mustafakinacii/zekaland-microduck-tr/modeller/README.md

# Modeller

| Klasör | İçerik |
|---|---|
| [`feetech/`](feetech/) | **Bambu Studio projesi** (`zekaland-robot-ordek-feetech.3mf`, 6 tabla, ayarlar hazır) ve tek tek STL'ler (`stl/`). Ayak tabanlarında ZEKALAND yazısı var. |
| [`zekaland/`](zekaland/) | Zekaland aksesuarları: sırt rozeti (52×14 mm) ve sergileme kaidesi (150×100 mm) |
| [`montaj-gorselleri/`](montaj-gorselleri/) | 15 alt grubun montaj ve patlatılmış görünüm resimleri |
| [`montaj-kilavuzu.pdf`](montaj-kilavuzu.pdf) | Montaj kılavuzu (Türkçe PDF, 23 sayfa, yazdırmaya hazır). Web sürümü: [belgeler/18-montaj-kilavuzu.md](../belgeler/18-montaj-kilavuzu.md) |

Baskı ayarları, süreler ve malzeme önerileri: [belgeler/12-baski-ve-cad.md](../belgeler/12-baski-ve-cad.md).

ZEKALAND parçaları
