mustafakinacii/zekaland-microduck-tr/belgeler/17-baslangic-rehberi.md

# İmaj Yazma ve İlk Kullanım

İmajı indirmekten, kartı yazmaya (imaj yazma) ve ağ yapılandırmasına; servo ve IMU kalibrasyonuna, gamepad eşleştirmeye ve yürümeye başlamaya kadar.

| Okuma biçimi | Giriş | Uygulandığı durum |
|---|---|---|
| **Güncel web sürümü açıklaması** | **[İmaj yazma ve ilk kullanım belgesini aç](10-imaj-yazma-ve-ilk-kullanim.md)** | Proje ile birlikte güncellenir, 20261023c'nin IMU uyumluluk kapsamını içerir |
| **PDF görselli rehber** | **[Başlangıç rehberi V2'yi önizle / indir](https://github.com/fanhao375/microduck-replica/blob/789ef5e45b6102d7e71fecefbf58606520147cfa/docs/上手指南/Microduck上手指南-V2-20261022.pdf)** | 2026-10-22'de derlendi, 21 sayfa, yazdırılabilir; görseller 20261021b imajına dayanır, sürüm farklarında güncel web sürümü açıklaması esas alınır |

PDF; indirme ve kart yazma, hotspot'a bağlanma ve ağ yapılandırması, servo ve IMU kalibrasyonu, gamepad, acil durdurma ve yürümeyi kapsar. Özgün doküman içeriği korunmuştur.

[İmajı indir](https://github.com/fanhao375/microduck-replica/releases/latest) · [CAD ve baskı dosyaları](https://github.com/fanhao375/microduck-replica-cad) · [Feetech sürümü satın alma listesi](02-malzeme-listesi-bom.md) · [Donanım projeleri](13-devre-kartlari.md)

---
*Zekaland Robot Ördek belgeleri · Lisans ve katkıda bulunanlar: [ATIF.md](../ATIF.md)*
