mustafakinacii/zekaland-microduck-tr/belgeler/02-malzeme-listesi-bom.md

# Feetech Sürümü Montaj Satın Alma Listesi

**Hazırlayan: 机械行者Robo · 2026-10-23 sürümü**

**[Tam Excel dosyasını indir](https://github.com/fanhao375/microduck-replica/blob/789ef5e45b6102d7e71fecefbf58606520147cfa/BOM/装配BOM-机械行者Robo-2026-10-23-带采购链接.xlsx)** · [Baskı parçaları ve CAD](https://github.com/fanhao375/microduck-replica-cad) · [Ana depo](https://github.com/fanhao375/microduck-replica)

Bu sayfa, aynı sürümün Excel dosyasından derlenmiştir; **33 baskı parçası ve 23 satın alınan parça** içerir. Adetler, malzemeler, notlar, fiyatlar ve satın alma bağlantıları orijinal tablodaki gibi korunmuştur.

**Geçerli sürüm: Feetech HD-1910 yapısı.** Liste, Feetech servoları ve URT2 programlama/test kartını içerir; XL330 sürümü için servolar ve ilgili elektronik ayrıca kontrol edilmelidir. Excel'in orijinal dosyası değiştirilmemiştir.

[Baskı parçalarına git](#1-baskı-parçaları-33-kalem) · [Satın alınan parçalara git](#2-satın-alınan-parçalar-23-kalem) · [Orijinal tablo notları ve doğrulanacak noktalar](#3-orijinal-tablo-notları-ve-doğrulanacak-noktalar)

## 1. Baskı parçaları (33 kalem)

Baskı modellerini [CAD deposundan](https://github.com/fanhao375/microduck-replica-cad) kendi servo sürümünüze uygun olarak seçin. Malzemeyi ayrıca o sürümün baskı açıklamasıyla karşılaştırın; aşağıdaki tabloda Excel'deki orijinal metin gösterilmektedir. (Dosya adlarındaki Çince bölümler orijinaldir ve değiştirilmemiştir.)

**Tüm baskı parçaları seti için fiyat kaydı: 139 yuan** (¥ = Çin yuanı), orijinal tablodaki birleştirilmiş I3:I35 alanına karşılık gelir; [satın alma bağlantısı (Taobao)](<https://item.taobao.com/item.htm?id=1083122166800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>).

| No | Ad | Orijinal dosya adı | Malzeme (orijinal tablo) | Adet | Not (orijinal tablo) |
|---|---|---|---|---:|---|
| 1 | Kafa üst kabuk | top_head_shell_头部上壳.stp | PLA | 1 |  |
| 2 | Kafa alt kabuk | bottom_head_shell_头部下壳.stp | PLA | 1 |  |
| 3 | Yüz parçası | face_part_面部零件.stp | PLA | 1 |  |
| 4 | Çene | jaw_下巴.stp | PLA | 1 |  |
| 5 | Yumuşak çene | jaw_soft_软下巴.stp | PLA | 1 | TPU esnek filament önerilir |
| 6 | Yumuşak gaga üstü | soft_mouth_top_软嘴顶部.stp | PLA | 1 | TPU esnek filament önerilir |
| 7 | Gözler | noenoeil_眼睛.stp | PLA | 1 |  |
| 8 | Boyun | neck_颈部.stp | PLA | 2 | Alüminyum alaşım önerilir |
| 9 | Boyun eğim (pitch) | neck_pitch_颈部俯仰.stp | PLA | 1 |  |
| 10 | Gövde tabanı | trunk_base_躯干底座.stp | PLA | 1 | Alüminyum alaşım önerilir |
| 11 | Sol kabuk | left_shell_左壳.stp | PLA | 1 |  |
| 12 | Sağ kabuk | right_shell_右壳.stp | PLA | 1 |  |
| 13 | Kalça sol | hip_l_髋部左.stp | PLA | 2 |  |
| 14 | Yaw'dan roll'a dönüşüm | yaw2roll_偏航转横滚.stp | PLA | 1 |  |
| 15 | Yaw-roll hareketi | yaw_roll_motion_偏航横滚运动.stp | PLA | 1 |  |
| 16 | Bacak | leg_腿部.stp | PLA | 2 |  |
| 17 | Sol üst bacak | left_upper_leg_左上腿.stp | PLA | 1 |  |
| 18 | Sağ üst bacak | right_upper_leg_右上腿.stp | PLA | 1 |  |
| 19 | Üst bacak takviye plakası | upper_leg_rigidity_plate_上腿加固板.stp | PLA | 2 | Alüminyum alaşım önerilir |
| 20 | Sol ayak | foot_left_左脚.stp | PLA | 1 |  |
| 21 | Sağ ayak | foot_right_右脚.stp | PLA | 1 |  |
| 22 | Sol taban | sole_left_左脚底.stp | PLA | 1 |  |
| 23 | Sağ taban | sole_right_右脚底.stp | PLA | 1 |  |
| 24 | Bilek sol | ankle_left_脚踝左.stp | PLA | 1 |  |
| 25 | Bilek sağ | ankle_right_脚踝右.stp | PLA | 1 |  |
| 26 | Bilek sol (V1 alternatif) | ankle_l_v1_脚踝左V1.stp | PLA | 1 |  |
| 27 | Bilek sağ (V1 alternatif) | ankle_r_v1_脚踝右V1.stp | PLA | 1 |  |
| 28 | Birleşik lastik | 合体轮胎.stp | PLA | 4 |  |
| 29 | Tekerlek kanadı | roller_blade_滚轮叶片.stp | PLA | 2 |  |
| 30 | Motor desteği | motor_support_电机支架.stp | PLA | 1 |  |
| 31 | Güç (batarya) desteği | power_support_电源支架.stp | PLA | 1 |  |
| 32 | Muz biçimli PCB kilidi | banana_pcb_locker_香蕉形PCB锁扣.stp | PLA | 1 |  |
| 33 | Rulmanlı tekerlek | bearing_roll_轴承滚轮.stp | PLA | 2 | Alüminyum alaşım önerilir |

## 2. Satın alınan parçalar (23 kalem)

Fiyat birimi yuandır (¥); değerler orijinal tabloda kayıtlı sayılar olarak gösterilmiştir. Satın alma bağlantılarına doğrudan tıklanabilir; Excel'de adres girilmemiş kalemler "Orijinal tabloda girilmemiş" olarak işaretlenmiştir.

| No | Ad | Kategori | Adet | Birim fiyat | Toplam fiyat (orijinal tablo) | Not (orijinal tablo) | Satın alma girişi |
|---|---|---|---:|---:|---:|---|---|
| 1 | Radxa Zero 3W ana kart | Elektronik parça | 1 | 309 | 309 |  | [Satın alma bağlantısı (Taobao)](<https://item.taobao.com/item.htm?id=763812025816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>) |
| 2 | 64GB TF (microSD) kart | Elektronik parça | 1 | 60 | 60 |  | Orijinal tabloda girilmemiş |
| 3 | Raspberry Pi robot HAT devre kartı | Elektronik parça | 1 | 120 | 120 | Ortak (grup) sipariş mümkün, GitHub | [Proje girişi (GitHub)](<https://github.com/fanhao375/microduck-replica>) |
| 4 | imu_to_dxl devre kartı | Elektronik parça | 1 | 80 | 80 | Ortak (grup) sipariş mümkün, GitHub | [Proje girişi (GitHub)](<https://github.com/fanhao375/microduck-replica>) |
| 5 | Feetech HD1901M servo | Elektronik parça | 15 | 95 | 1425 | Ortak (grup) sipariş mümkün, GitHub | [Proje girişi (GitHub)](<https://github.com/fanhao375/microduck-replica>) |
| 6 | Feetech servo URT2 programlama/test kartı | Elektronik parça | 1 | 45 | 45 |  | [Satın alma bağlantısı (Taobao)](<https://item.taobao.com/item.htm?id=575365901461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>) |
| 7 | NP-F550 batarya | Elektronik parça | 1 | 17 | 47 |  | [Satın alma bağlantısı (Taobao)](<https://item.taobao.com/item.htm?id=769425140324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>) |
| 8 | AMP2.0 çift uçlu dönüşüm kablosu, microduck servo kablosu | Elektronik parça | 1 | 2 | 2 | Hata ayıklama için | [Satın alma bağlantısı (Taobao)](<https://item.taobao.com/item.htm?id=1089647066599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>) |
| 9 | 2.5mm muz (banana) fişi, PCB tipi, altın kaplama bakır | Elektronik parça | 2 | 1.6 | 3.2 |  | [Satın alma bağlantısı (Taobao)](<https://item.taobao.com/item.htm?id=1066300439603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>) |
| 10 | banana PCB | Elektronik parça | 1 | 20 | 20 |  | JLCPCB |
| 11 | IMX219 kamera modülü | Optik parça | 1 | 46.8 | 46.8 |  | [Satın alma bağlantısı (Tmall)](<https://detail.tmall.com/item.htm?id=775872575316>) |
| 12 | VL53L8CX ToF modülü | Elektronik parça | 1 | 49.5 | 49.5 |  | [Satın alma bağlantısı (Taobao)](<https://item.taobao.com/item.htm?id=737603917521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>) |
| 13 | Hoparlör | Elektronik parça | 1 | 3.8 | 3.8 |  | [Satın alma bağlantısı (Taobao)](<https://item.taobao.com/item.htm?id=902489608878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>) |
| 14 | Rulman 10×15×3 | Standart parça | 3 | 2.8 | 8.4 |  | [Satın alma bağlantısı (Taobao)](<https://item.taobao.com/item.htm?id=670727787832>) |
| 15 | Rulman 16×22×4 | Standart parça | 11 | 3.5 | 38.5 |  | [Satın alma bağlantısı (Taobao)](<https://item.taobao.com/item.htm?id=539024647147&skuId=5716548727712>) |
| 16 | Rulman 6×12×3 | Standart parça | 4 | 0.88 | 3.52 | Paten rulmanı | [Satın alma bağlantısı (Taobao)](<https://item.taobao.com/item.htm?id=963037239628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>) |
| 17 | Sac vidası, düz başlı M2×5 | Standart parça | 1 paket | 3.05 | 3.05 |  | [Satın alma bağlantısı (Tmall)](<https://detail.tmall.com/item.htm?id=534923831046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>) |
| 18 | Sac vidası, düz başlı M2×6 | Standart parça | 1 paket | 4.05 | 4.05 |  | [Satın alma bağlantısı (Tmall)](<https://detail.tmall.com/item.htm?id=534923831046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>) |
| 19 | Sac vidası, düz başlı M2×8 | Standart parça | 1 paket | 4.05 | 4.05 |  | [Satın alma bağlantısı (Tmall)](<https://detail.tmall.com/item.htm?id=534923831046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>) |
| 20 | Sac vidası, düz başlı M2.5×6 | Standart parça | 1 paket | 3.93 | 3.93 |  | [Satın alma bağlantısı (Taobao)](<https://item.taobao.com/item.htm?id=534923831046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>) |
| 21 | Sac vidası, düz başlı M2.5×8 | Standart parça | 1 paket | 2.08 | 2.08 |  | [Satın alma bağlantısı (Taobao)](<https://item.taobao.com/item.htm?id=534923831046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>) |
| 22 | Loctite 243 vida sabitleyici | Standart parça | 1 | 9 | 9 |  | [Satın alma bağlantısı (Taobao)](<https://item.taobao.com/item.htm?id=1056442610986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>) |
| 23 | Ayakkabı tabanı kaymaz ped | Standart parça | 1 | 16 | 16 |  | [Satın alma bağlantısı (Tmall)](<https://detail.tmall.com/item.htm?id=888852278057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>) |

## 3. Orijinal tablo notları ve doğrulanacak noktalar

**Orijinal tablo toplamı: 2426.88 yuan.** Excel'in orijinal dosyası değiştirilmemiştir; aşağıdaki iki noktanın kontrol edilmesi gerekir:

- Toplam formülü `SUM(I3:I58)` olup son kalem olan "ayakkabı tabanı kaymaz ped"i (I59, 16 yuan) içermemektedir.
- "NP-F550 batarya" satırında adet 1, birim fiyat 17 yuan, toplam fiyat 47 yuandır; birim fiyat ile toplam fiyat tutarsızdır.

<details>
<summary>Yazarın Excel'e eklediği orijinal açıklamayı göster</summary>

Açıklama:
🦆 Herkes kendi MicroDuck'ına sahip olabilir!

💰 Proje maliyeti açıklaması
15 servo, HAT kartı ve IMU kartı dışındaki donanımın maliyeti yaklaşık 828 yuandır.
15 servo, HAT kartı ve IMU kartı için GitHub projesi üzerinden ortak (grup) siparişe katılabilir veya ihtiyaca göre JLCPCB, Taobao gibi platformlardan kendiniz satın alabilirsiniz.
İlerleyen dönemde, herkesin MicroDuck'ı daha kolay monte edip hata ayıklayabilmesi için montaj eğitimi ve hata ayıklama eğitimi de açık kaynak olarak yayımlanacaktır.
🤖 Neden açık kaynak?

Daha fazla insanın düşük maliyetle somutlaşmış zekâ (embodied AI), robot kontrolü ve pekiştirmeli öğrenme ile tanışıp öğrenebilmesini istiyoruz.

Herkesin kendi ördeği olsun.

Açık kaynak sayesinde, daha fazla insanın uygulamalı çalışıp sıfırdan somutlaşmış zekâyı keşfedebileceği daha açık ve dostane bir öğrenme ortamını birlikte kurmayı hedefliyoruz.

Bu proje size yardımcı olduysa beğeni bırakmak bize verebileceğiniz en büyük destektir ❤️

GitHub hesabımızı takip edip bir Star ⭐ vermeniz de çok makbule geçer!

🔗 GitHub:
https://github.com/fanhao375/microduck-replica

📕 Xiaohongshu: 机械行者
🎵 Douyin: 机械行者Robo
Bilibili: 机械行者Robo

</details>

---
*Zekaland Robot Ördek belgeleri · Lisans ve katkıda bulunanlar: [ATIF.md](../ATIF.md)*
