mustafakinacii/zekaland-microduck-tr/modeller/feetech/stl/upper_leg_rigidity_plate-FT_2.stl

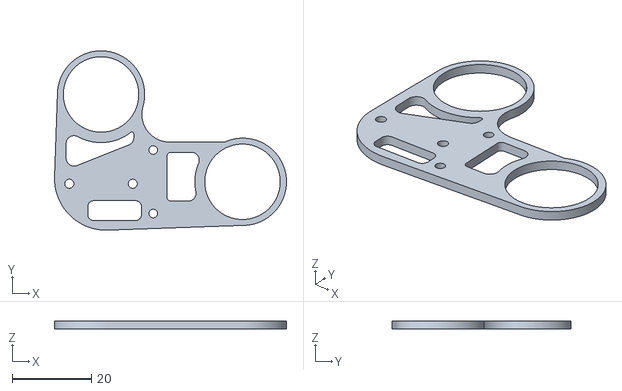
[picture p7: CAD file, 2026-10-30]
modeller/feetech/stl/upper_leg_rigidity_plate-FT_2.stl
58.5 x 45.2 x 2.00
