mustafakinacii/zekaland-microduck-tr/modeller/zekaland/zekaland_rozet.stl

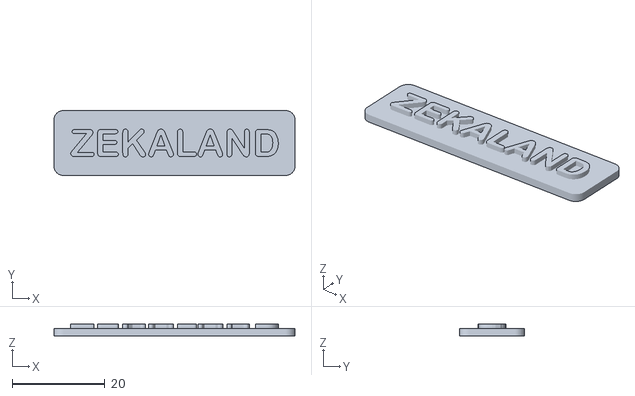
[picture p9: CAD file, 2026-10-30]
modeller/zekaland/zekaland_rozet.stl
52.0 x 14.0 x 2.60
