mustafakinacii/zekaland-microduck-tr/software/training/src/mjlab_microduck/robot/xl330_test_bench/assets/arm.stl

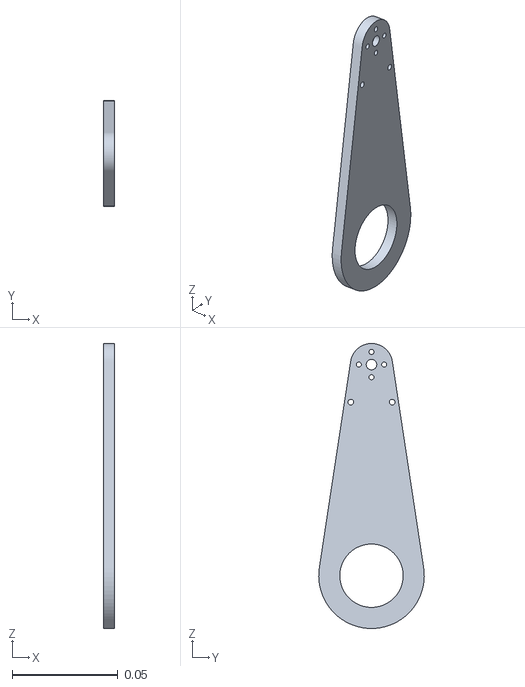
[picture p11: CAD file, 2026-10-30]
software/training/src/mjlab_microduck/robot/xl330_test_bench/assets/arm.stl
0.005 x 0.05 x 0.135
