mustafakinacii/zekaland-microduck-tr/modeller/feetech/stl/bearing_roll-FT.stl

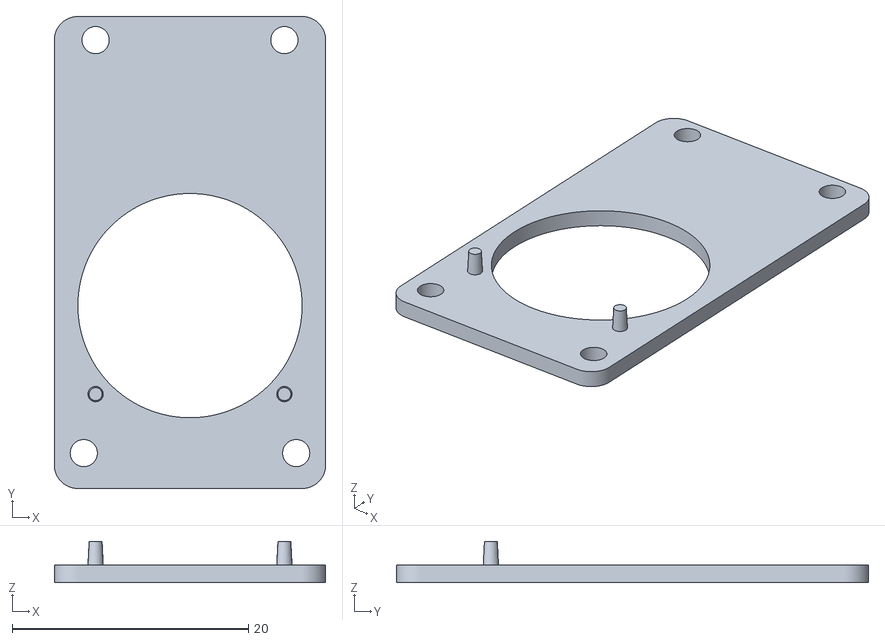
[picture p12: CAD file, 2026-10-30]
modeller/feetech/stl/bearing_roll-FT.stl
23.0 x 40.0 x 3.50
