mustafakinacii/zekaland-microduck-tr/modeller/zekaland/zekaland_kaide.stl

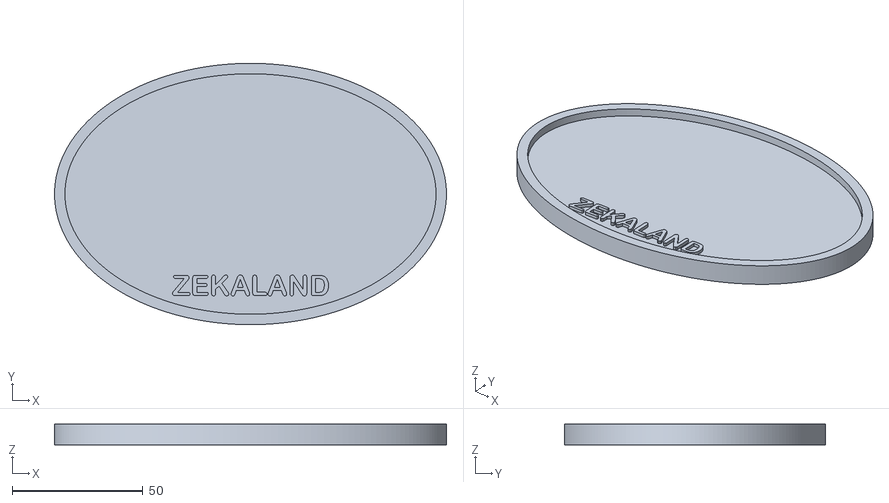
[picture p13: CAD file, 2026-10-30]
modeller/zekaland/zekaland_kaide.stl
150.0 x 100.0 x 8.00
