mustafakinacii/zekaland-microduck-tr/software/training/src/mjlab_microduck/robot/microduck/assets/rim.stl

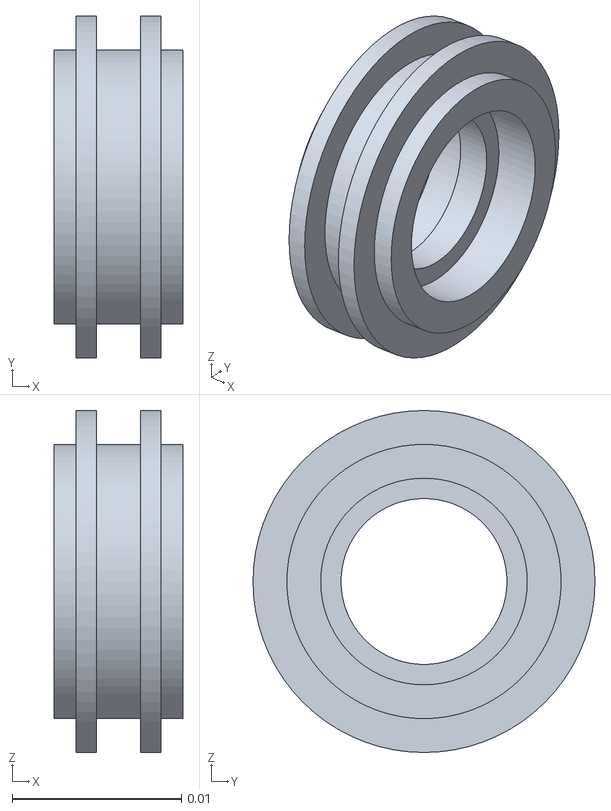
[picture p14: CAD file, 2026-10-30]
software/training/src/mjlab_microduck/robot/microduck/assets/rim.stl
0.0076 x 0.0202 x 0.0202
