mustafakinacii/zekaland-microduck-tr/modeller/feetech/stl/neck_pitch.stl

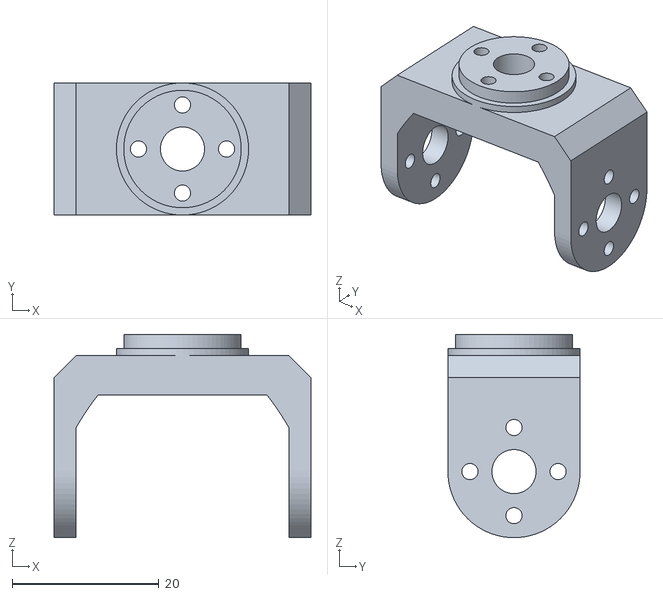
[picture p15: CAD file, 2026-10-30]
modeller/feetech/stl/neck_pitch.stl
35.0 x 18.0 x 27.7
