mustafakinacii/zekaland-microduck-tr/software/training/src/mjlab_microduck/robot/xl330_test_bench/assets/spacer.stl

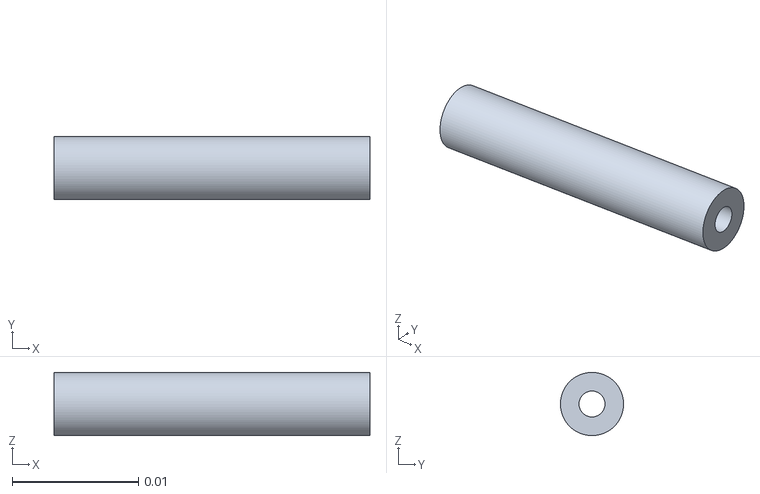
[picture p17: CAD file, 2026-10-30]
software/training/src/mjlab_microduck/robot/xl330_test_bench/assets/spacer.stl
0.025 x 0.005 x 0.005
