mustafakinacii/zekaland-microduck-tr/modeller/feetech/stl/ankle_l_v1_V1.stl

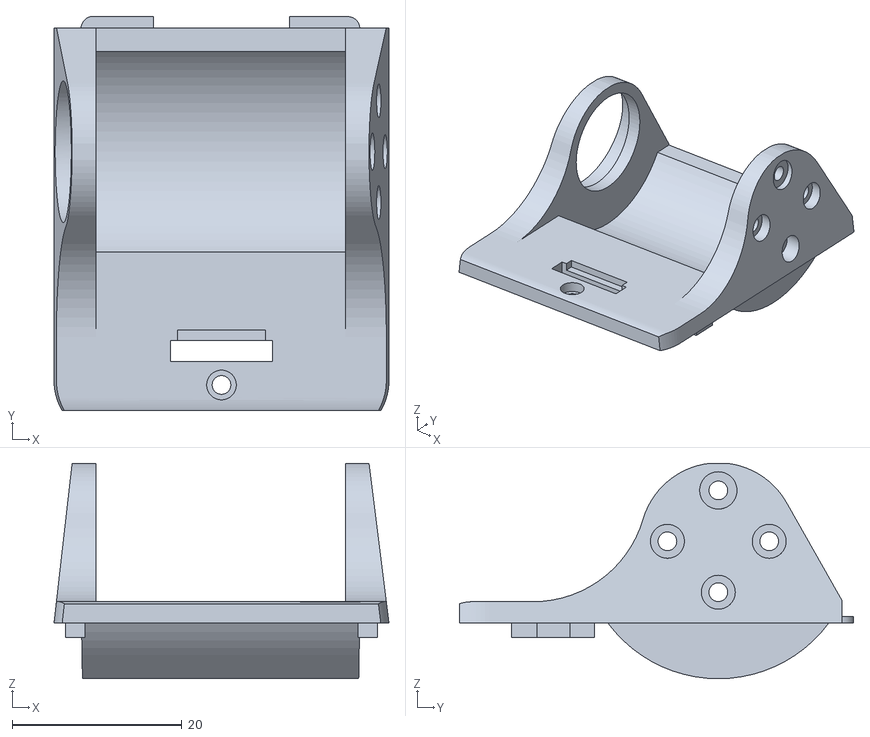
[picture p18: CAD file, 2026-10-30]
modeller/feetech/stl/ankle_l_v1_V1.stl
39.5 x 46.5 x 25.4
