mustafakinacii/zekaland-microduck-tr/software/training/src/mjlab_microduck/robot/microduck/assets/sole_right.stl

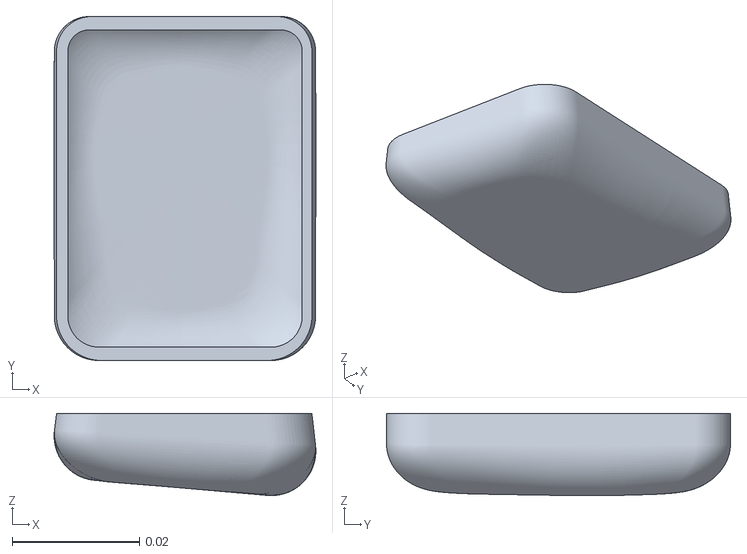
[picture p19: CAD file, 2026-10-30]
software/training/src/mjlab_microduck/robot/microduck/assets/sole_right.stl
0.0411 x 0.054 x 0.0129
