mustafakinacii/zekaland-microduck-tr/software/training/src/mjlab_microduck/robot/xl330_test_bench/assets/weight.stl

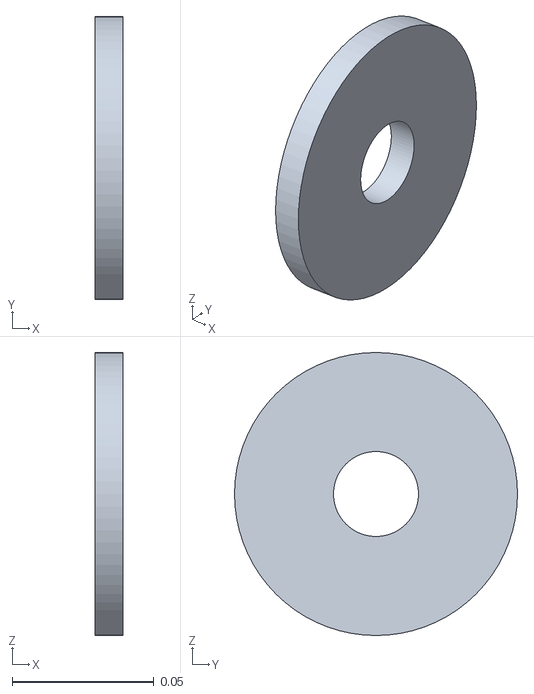
[picture p22: CAD file, 2026-10-30]
software/training/src/mjlab_microduck/robot/xl330_test_bench/assets/weight.stl
0.01 x 0.1 x 0.1
