mustafakinacii/zekaland-microduck-tr/modeller/feetech/stl/yaw_roll_motion-F.stl

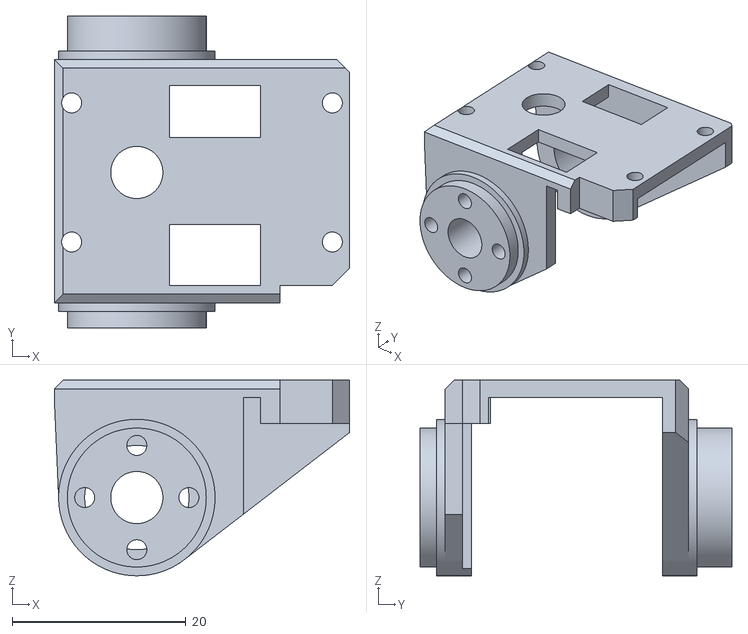
[picture p23: CAD file, 2026-10-30]
modeller/feetech/stl/yaw_roll_motion-F.stl
34.0 x 35.9 x 22.5
