mustafakinacii/zekaland-microduck-tr/modeller/feetech/stl/motor_support.stl

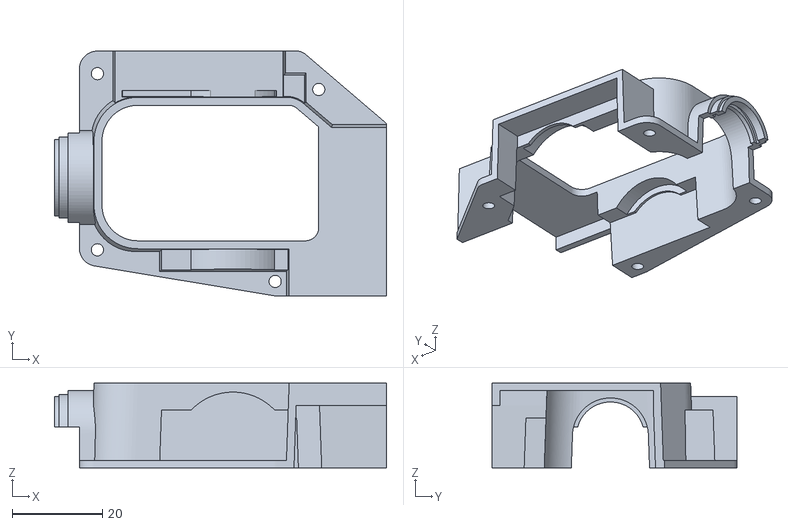
[picture p26: CAD file, 2026-10-30]
modeller/feetech/stl/motor_support.stl
73.5 x 54.2 x 18.8
