mustafakinacii/zekaland-microduck-tr/modeller/feetech/stl/combined_tire_TPU.stl

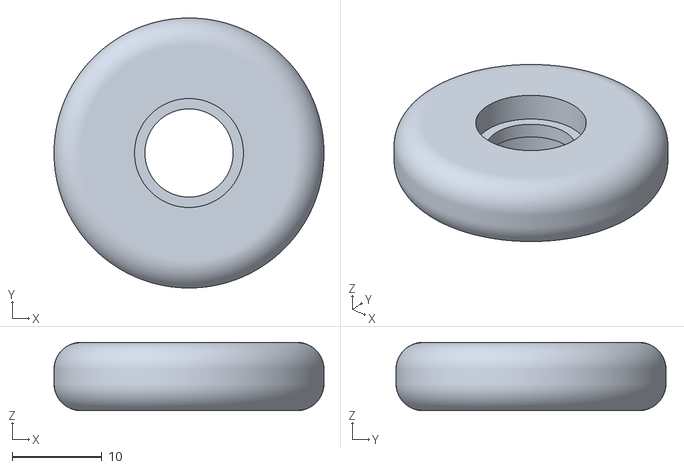
[picture p28: CAD file, 2026-10-30]
modeller/feetech/stl/combined_tire_TPU.stl
30.0 x 30.0 x 7.60
