mustafakinacii/zekaland-microduck-tr/software/training/src/mjlab_microduck/robot/microduck/assets/right_upper_leg.stl

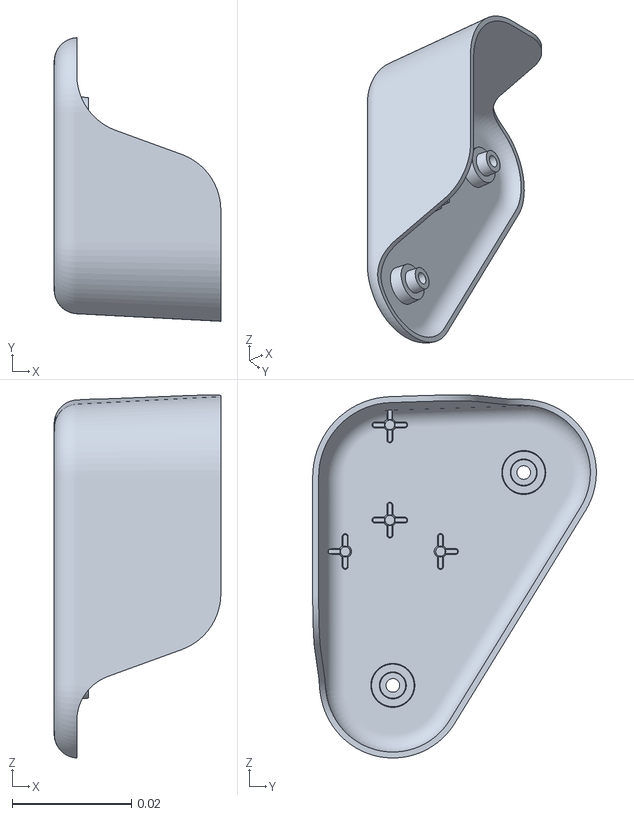
[picture p29: CAD file, 2026-10-30]
software/training/src/mjlab_microduck/robot/microduck/assets/right_upper_leg.stl
0.028 x 0.0477 x 0.061
