mustafakinacii/zekaland-microduck-tr/modeller/feetech/stl/hip_l.stl

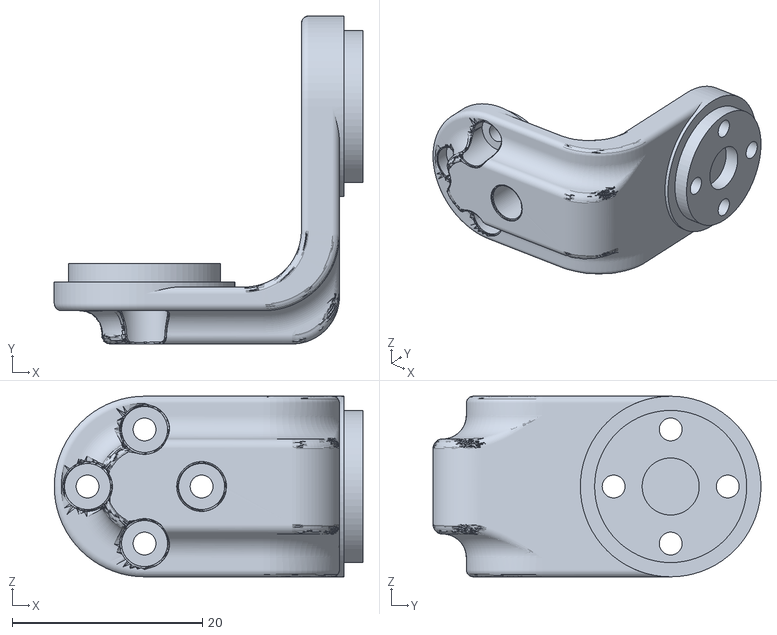
[picture p32: CAD file, 2026-10-30]
modeller/feetech/stl/hip_l.stl
32.5 x 34.5 x 19.0
