mustafakinacii/zekaland-microduck-tr/software/training/src/mjlab_microduck/robot/microduck/assets/ankle_r_v1.stl

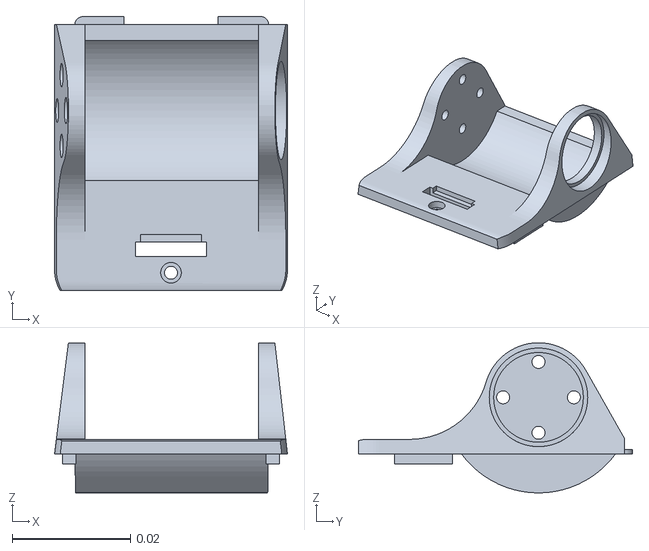
[picture p33: CAD file, 2026-10-30]
software/training/src/mjlab_microduck/robot/microduck/assets/ankle_r_v1.stl
0.0395 x 0.0465 x 0.0254
