mustafakinacii/zekaland-microduck-tr/modeller/feetech/stl/jaw_soft.stl

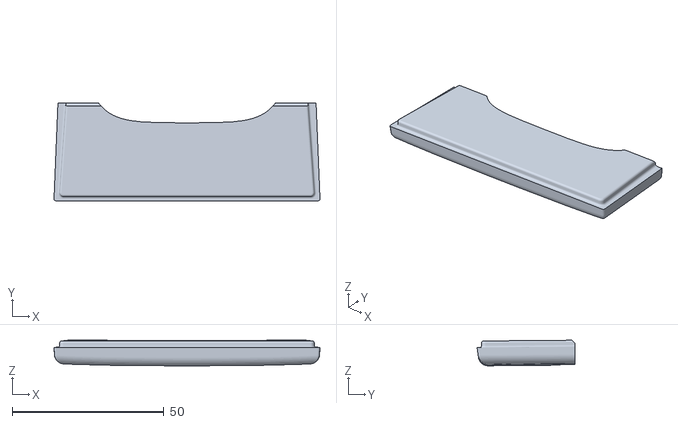
[picture p34: CAD file, 2026-10-30]
modeller/feetech/stl/jaw_soft.stl
87.7 x 32.2 x 8.44
