mustafakinacii/zekaland-microduck-tr/modeller/feetech/stl/yaw2roll-FT.stl

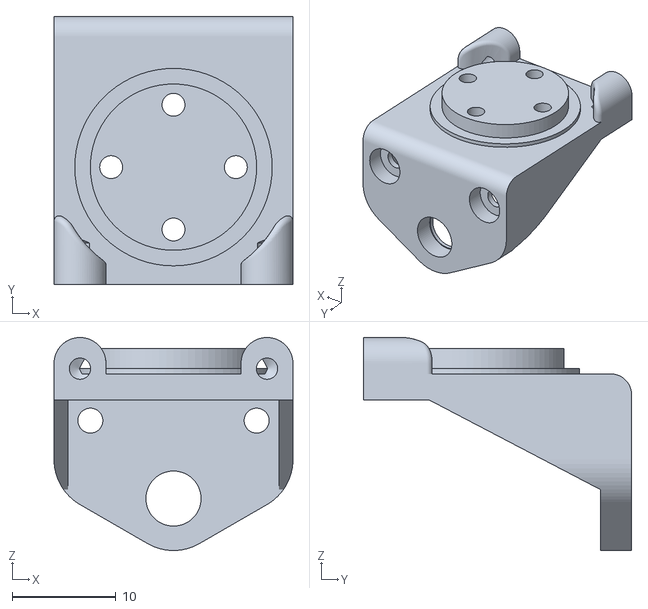
[picture p36: CAD file, 2026-10-30]
modeller/feetech/stl/yaw2roll-FT.stl
23.0 x 25.8 x 20.5
