mustafakinacii/zekaland-microduck-tr/modeller/feetech/stl/roller_blade_2.stl

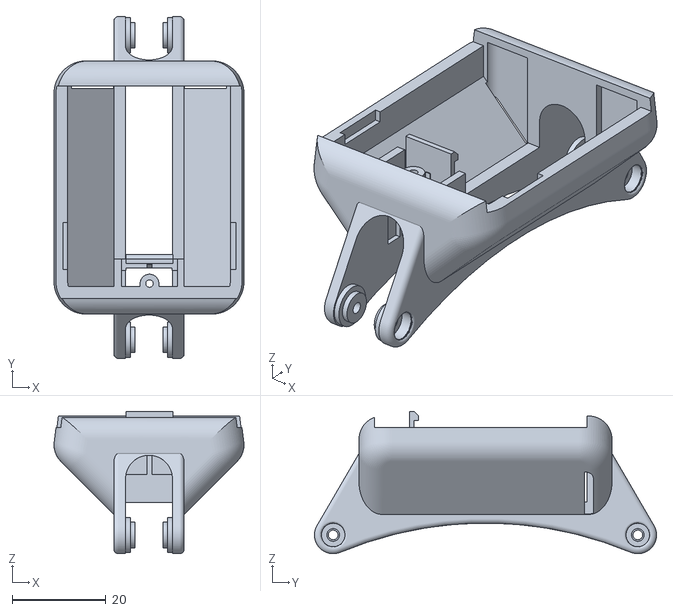
[picture p38: CAD file, 2026-10-30]
modeller/feetech/stl/roller_blade_2.stl
40.5 x 73.0 x 30.4
