mustafakinacii/zekaland-microduck-tr/modeller/feetech/stl/bottom_head_shell.stl

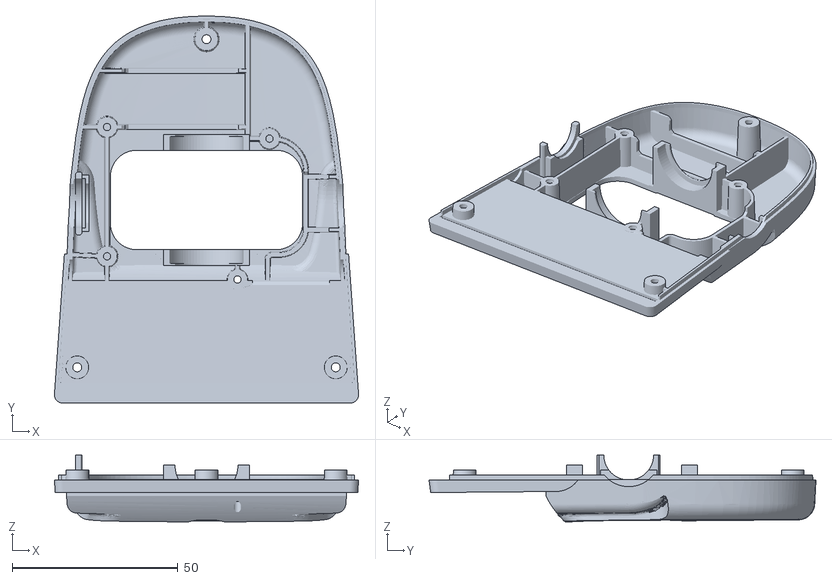
[picture p40: CAD file, 2026-10-30]
modeller/feetech/stl/bottom_head_shell.stl
91.8 x 116.7 x 20.1
