mustafakinacii/zekaland-microduck-tr/modeller/feetech/stl/neck.stl

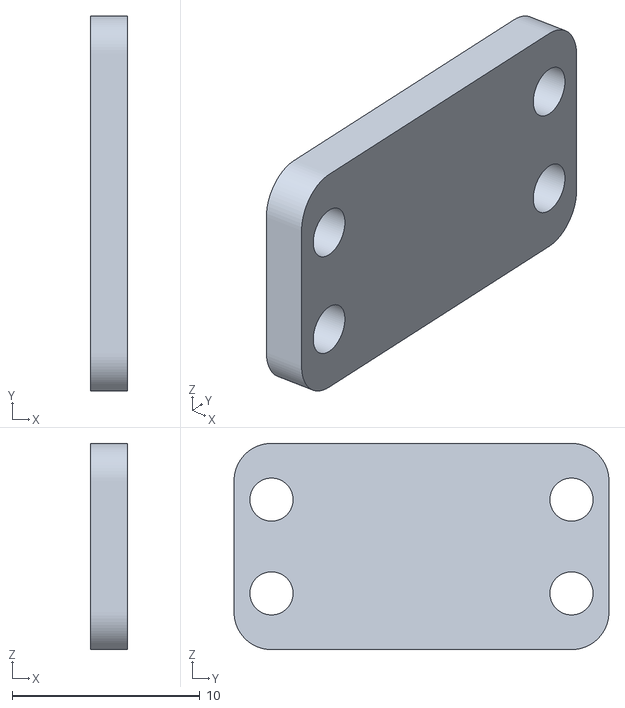
[picture p42: CAD file, 2026-10-30]
modeller/feetech/stl/neck.stl
2.00 x 20.0 x 11.0
