mustafakinacii/zekaland-microduck-tr/modeller/feetech/stl/trunk_base.stl

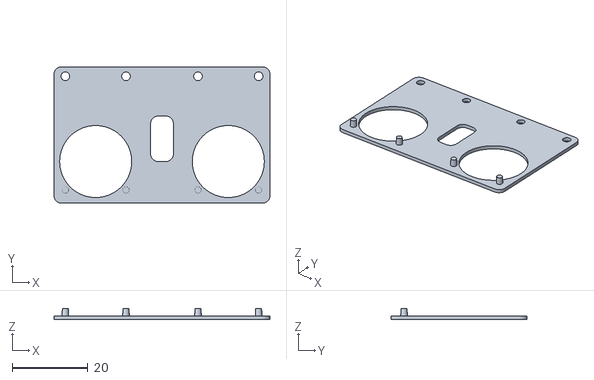
[picture p44: CAD file, 2026-10-30]
modeller/feetech/stl/trunk_base.stl
57.0 x 36.0 x 3.00
