mustafakinacii/zekaland-microduck-tr/modeller/feetech/stl/left_upper_leg-FT.stl

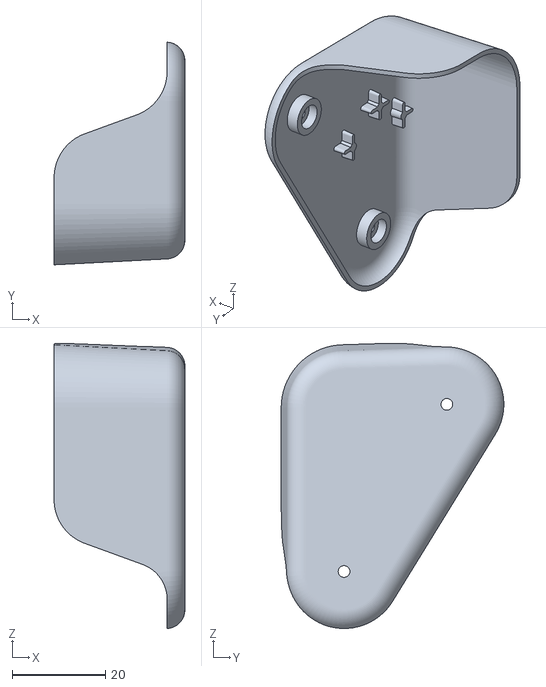
[picture p46: CAD file, 2026-10-30]
modeller/feetech/stl/left_upper_leg-FT.stl
28.0 x 47.7 x 61.0
