mustafakinacii/zekaland-microduck-tr/modeller/feetech/stl/sole_left_ZEKALAND.stl

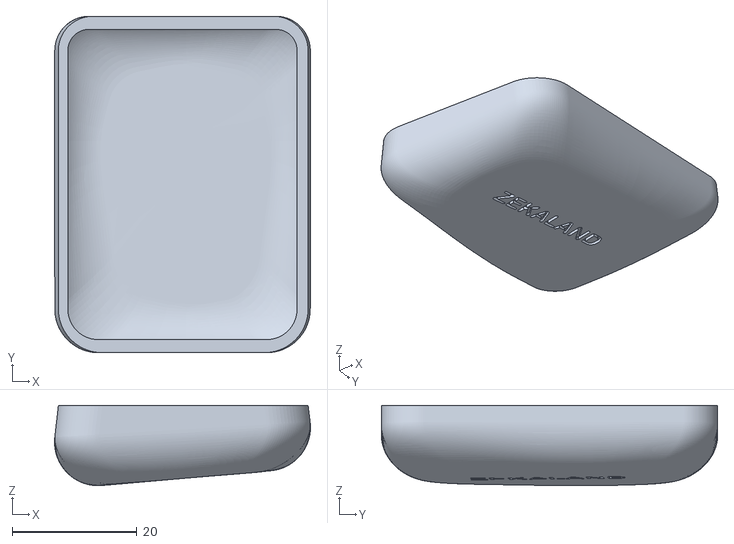
[picture p48: CAD file, 2026-10-30]
modeller/feetech/stl/sole_left_ZEKALAND.stl
41.1 x 54.0 x 12.9
