mustafakinacii/zekaland-microduck-tr/modeller/feetech/stl/foot_left.stl

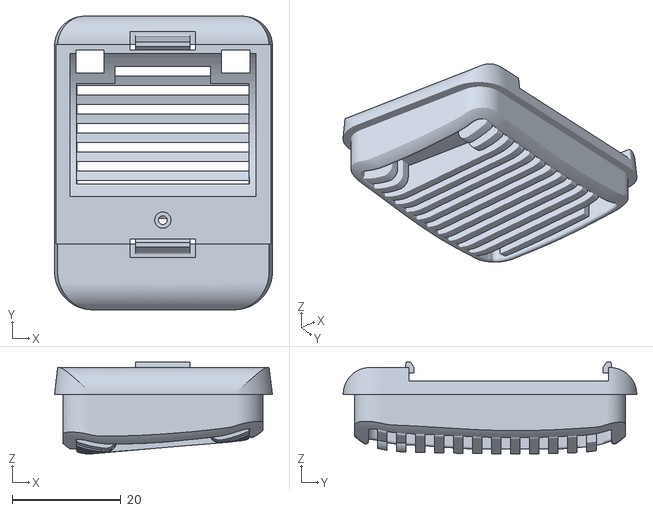
[picture p51: CAD file, 2026-10-30]
modeller/feetech/stl/foot_left.stl
40.1 x 54.0 x 16.9
