mustafakinacii/zekaland-microduck-tr/modeller/feetech/stl/banana_pcb_locker_PCB.stl

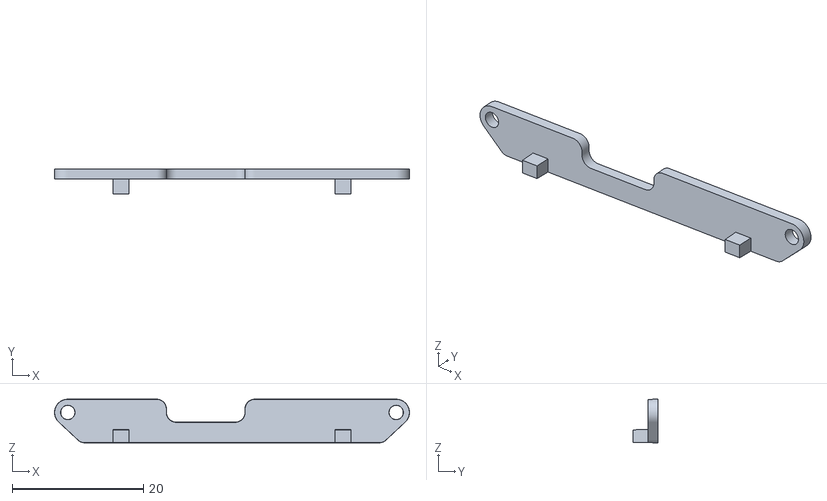
[picture p53: CAD file, 2026-10-30]
modeller/feetech/stl/banana_pcb_locker_PCB.stl
54.1 x 3.80 x 6.65
