mustafakinacii/zekaland-microduck-tr/modeller/feetech/stl/face_part.stl

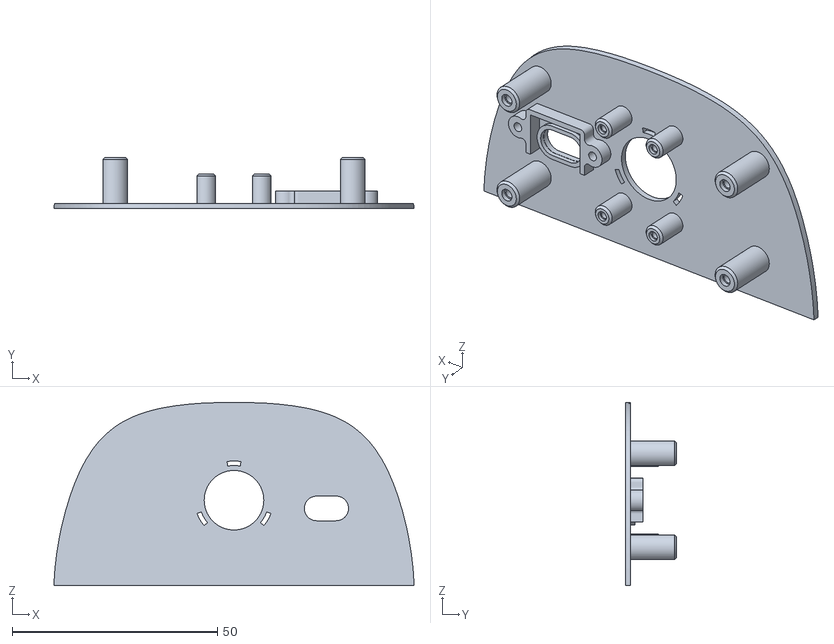
[picture p55: CAD file, 2026-10-30]
modeller/feetech/stl/face_part.stl
87.7 x 12.5 x 44.6
