mustafakinacii/zekaland-microduck-tr/software/training/src/mjlab_microduck/robot/microduck/assets/neck.stl

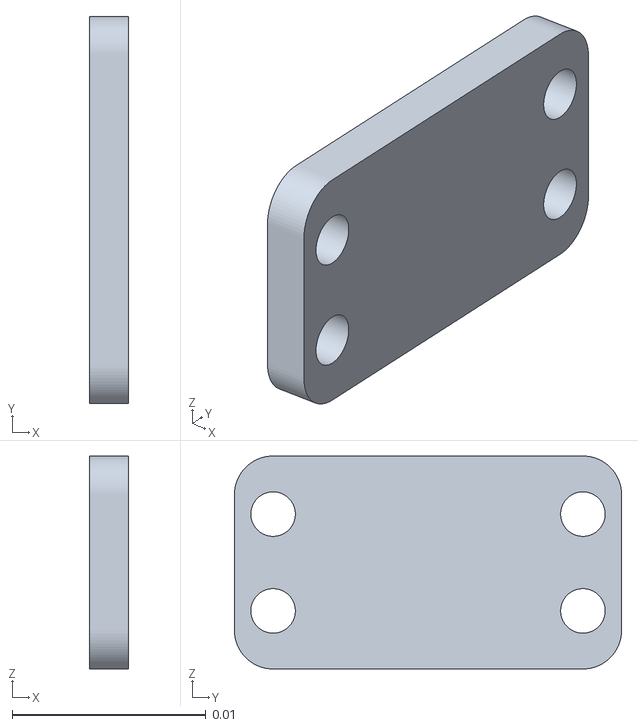
[picture p56: CAD file, 2026-10-30]
software/training/src/mjlab_microduck/robot/microduck/assets/neck.stl
0.002 x 0.02 x 0.011
