mustafakinacii/zekaland-microduck-tr/modeller/feetech/stl/right_shell.stl

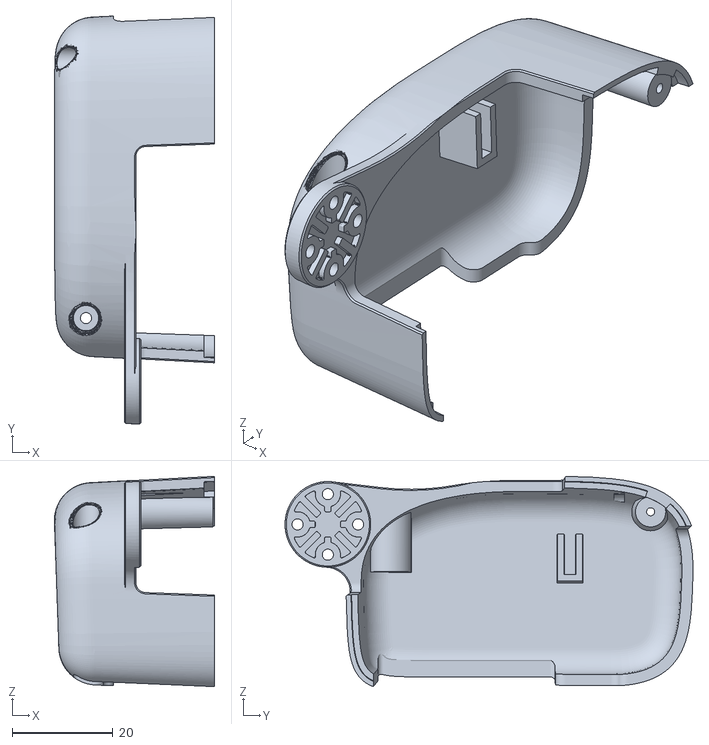
[picture p57: CAD file, 2026-10-30]
modeller/feetech/stl/right_shell.stl
31.8 x 80.9 x 41.7
