mustafakinacii/zekaland-microduck-tr/modeller/feetech/stl/leg-FT_2.stl

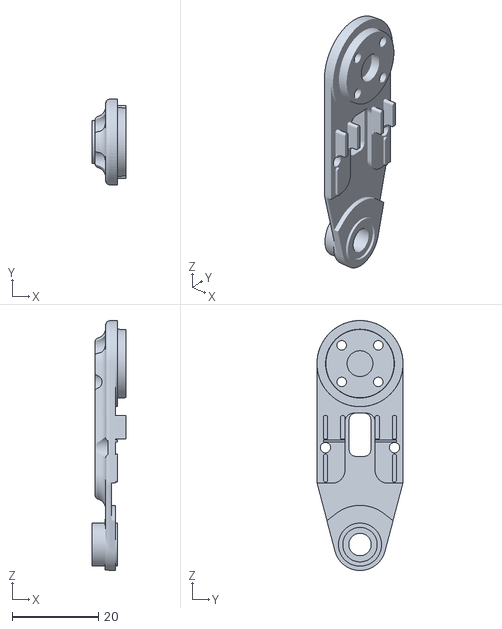
[picture p59: CAD file, 2026-10-30]
modeller/feetech/stl/leg-FT_2.stl
7.95 x 20.0 x 58.0
