mustafakinacii/zekaland-microduck-tr/software/training/src/mjlab_microduck/robot/microduck/assets/trunk_shell_left.stl

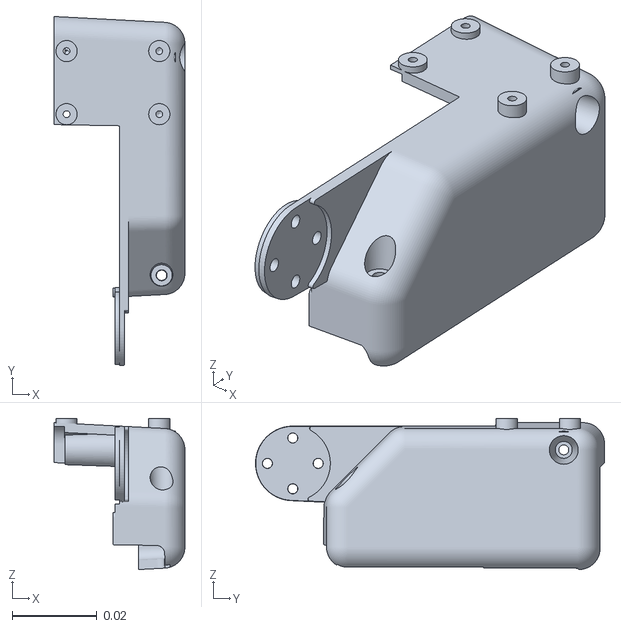
[picture p60: CAD file, 2026-10-30]
software/training/src/mjlab_microduck/robot/microduck/assets/trunk_shell_left.stl
0.0309 x 0.0824 x 0.0357
