mustafakinacii/zekaland-microduck-tr/modeller/feetech/stl/power_support.stl

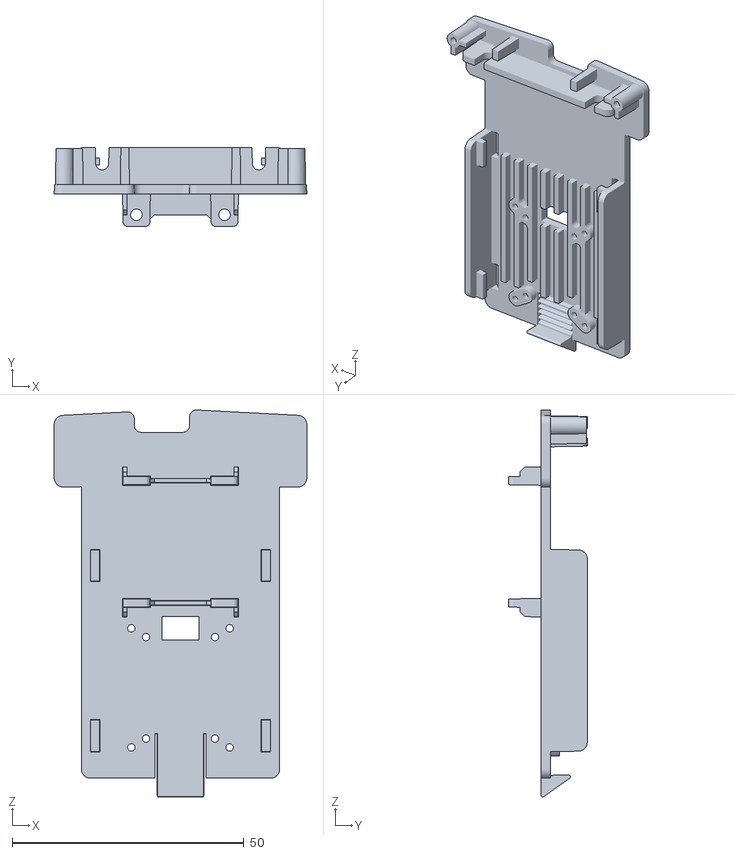
[picture p62: CAD file, 2026-10-30]
modeller/feetech/stl/power_support.stl
54.5 x 17.0 x 83.5
