mustafakinacii/zekaland-microduck-tr/modeller/feetech/stl/noenoeil.stl

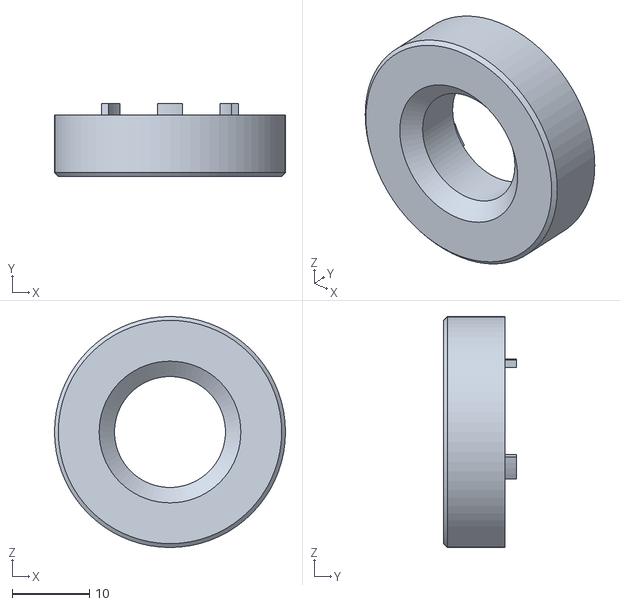
[picture p64: CAD file, 2026-10-30]
modeller/feetech/stl/noenoeil.stl
30.0 x 9.50 x 30.0
