mustafakinacii/zekaland-microduck-tr/modeller/feetech/stl/soft_mouth_top.stl

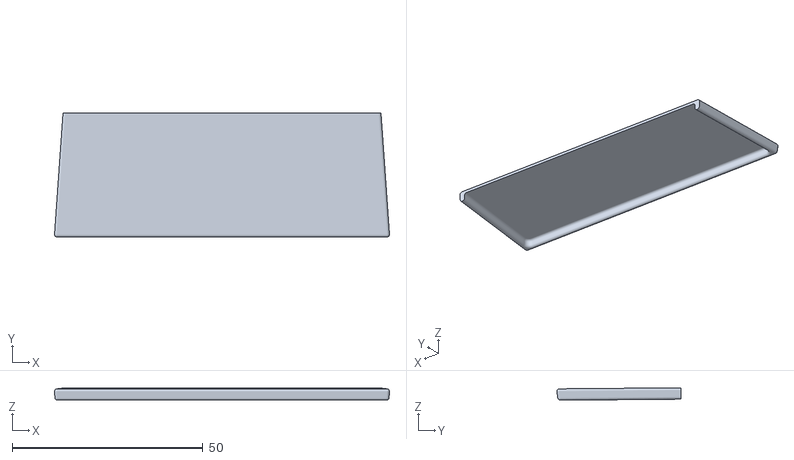
[picture p66: CAD file, 2026-10-30]
modeller/feetech/stl/soft_mouth_top.stl
87.8 x 32.6 x 3.28
