mustafakinacii/zekaland-microduck-tr/modeller/feetech/stl/left_shell-FT.stl

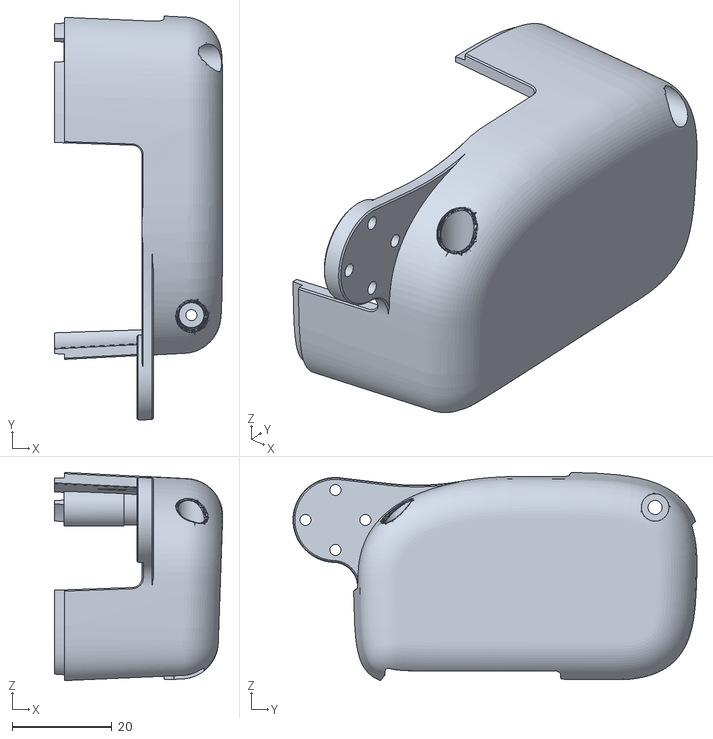
[picture p67: CAD file, 2026-10-30]
modeller/feetech/stl/left_shell-FT.stl
33.7 x 80.9 x 41.7
