mustafakinacii/zekaland-microduck-tr/modeller/feetech/stl/ankle_left.stl

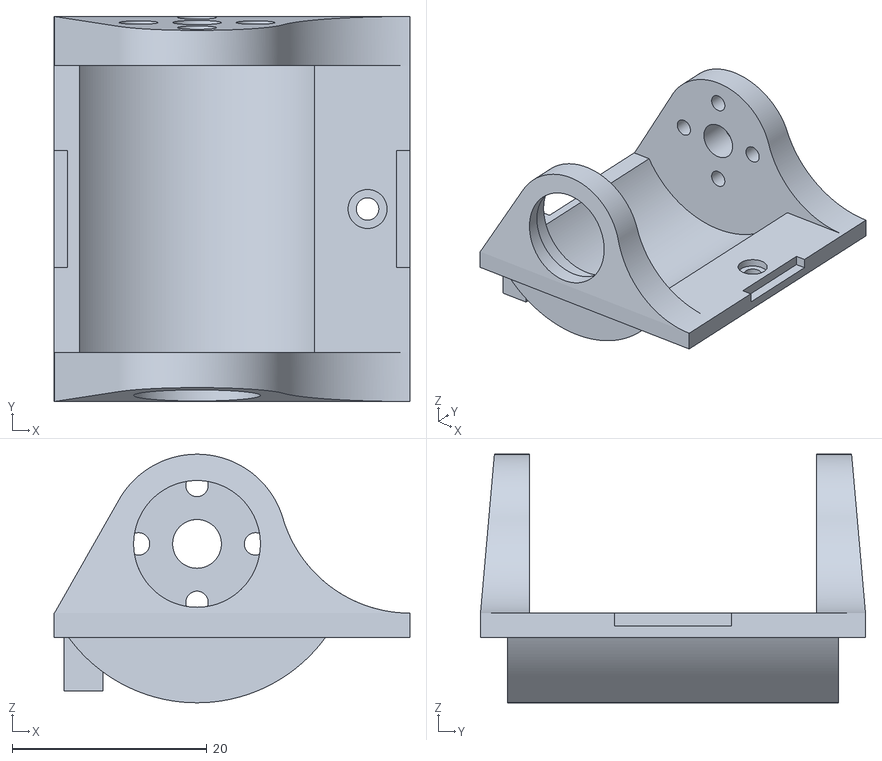
[picture p69: CAD file, 2026-10-30]
modeller/feetech/stl/ankle_left.stl
36.5 x 39.5 x 25.5
