mustafakinacii/zekaland-microduck-tr/modeller/feetech/stl/top_head_shell-FT.stl

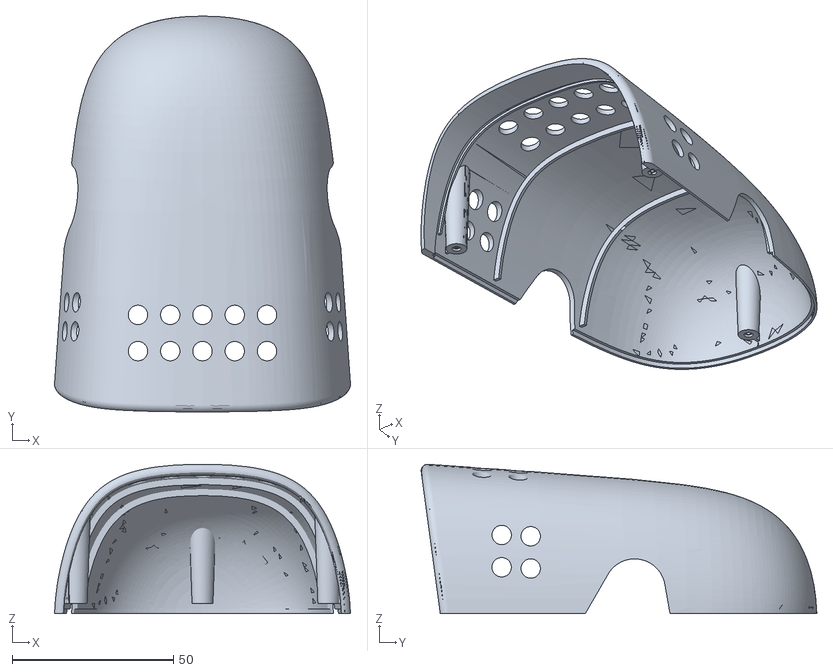
[picture p72: CAD file, 2026-10-30]
modeller/feetech/stl/top_head_shell-FT.stl
91.8 x 122.7 x 46.3
