mustafakinacii/zekaland-microduck-tr/modeller/feetech/stl/jaw.stl

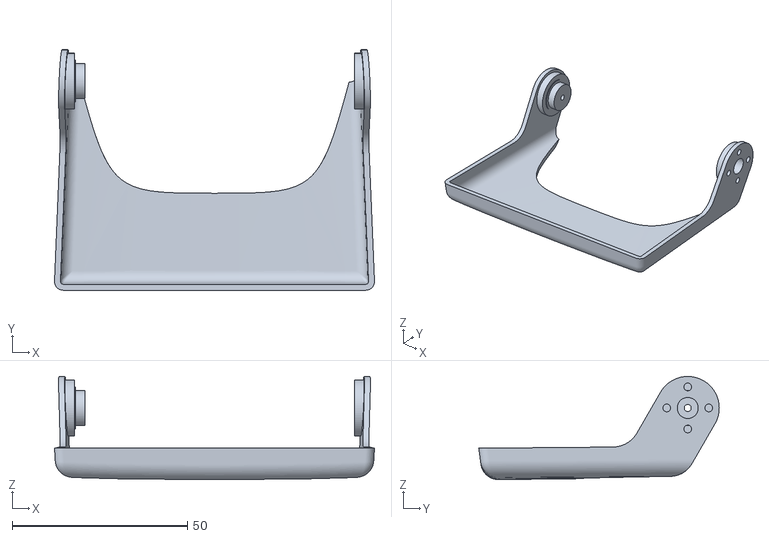
[picture p77: CAD file, 2026-10-30]
modeller/feetech/stl/jaw.stl
91.4 x 68.7 x 29.4
