mustafakinacii/zekaland-microduck-tr/(list of files, cad)

Other CAD files:
modeller/feetech/stl/ankle_r_v1_V1.stl
modeller/feetech/stl/foot_right.stl
software/training/src/mjlab_microduck/robot/microduck/assets/upper_leg_left.stl
modeller/feetech/stl/sole_right_ZEKALAND.stl
software/training/src/mjlab_microduck/robot/microduck/assets/ankle_l_v1.stl
software/training/src/mjlab_microduck/robot/microduck/assets/left_upper_leg.stl
software/training/src/mjlab_microduck/robot/microduck/assets/ankle_left.stl
modeller/feetech/stl/right_upper_leg-FT.stl
software/training/src/mjlab_microduck/robot/microduck/assets/sole_left.stl
software/training/src/mjlab_microduck/robot/microduck/assets/foot_left.stl
software/training/src/mjlab_microduck/robot/microduck/assets/upper_leg_right.stl
