mustafakinacii/zekaland-microduck-tr/modeller/montaj-gorselleri/00-tam-montaj-2.png

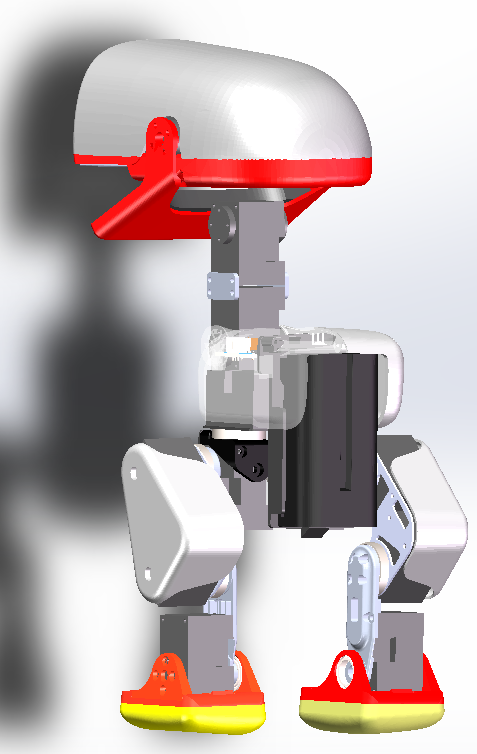
modeller/montaj-gorselleri/00-tam-montaj-2.png
