mustafakinacii/zekaland-microduck-tr/software/studio/tests/fixtures/battery-20261012-1532.csv

# 来源：health-20261012-153248.csv + run-20261012-153248.jsonl（一号鸭，build_fixture.py 反推）
t | v | cls
0 | 7.521 | light
1 | 7.533 | light
2 | 7.506 | light
3 | 7.506 | light
4 | 7.526 | light
5 | 7.528 | light
6 | 7.550 | light
7 | 7.544 | light
8 | 7.537 | light
9 | 7.519 | light
10 | 7.539 | light
11 | 7.531 | light
12 | 7.492 | light
13 | 7.489 | light
14 | 7.486 | light
15 | 7.513 | light
16 | 7.513 | light
17 | 7.513 | light
18 | 7.493 | light
19 | 7.461 | light
20 | 7.496 | light
21 | 7.505 | light
22 | 7.495 | light
23 | 7.494 | light
24 | 7.503 | light
25 | 7.493 | light
26 | 7.482 | light
27 | 7.500 | light
28 | 7.490 | light
29 | 7.489 | light
30 | 7.498 | light
31 | 7.488 | light
32 | 7.507 | light
33 | 7.498 | light
34 | 7.488 | light
35 | 7.487 | light
36 | 7.486 | light
37 | 7.495 | light
38 | 7.495 | light
39 | 7.495 | light
40 | 7.495 | light
41 | 7.505 | light
42 | 7.476 | light
43 | 7.504 | light
44 | 7.505 | light
45 | 7.516 | light
46 | 7.508 | light
47 | 7.489 | light
48 | 7.498 | light
49 | 7.498 | light
50 | 7.478 | light
51 | 7.476 | light
52 | 7.474 | light
53 | 7.472 | light
54 | 7.500 | light
55 | 7.501 | light
56 | 7.482 | light
57 | 7.491 | light
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
