mustafakinacii/zekaland-microduck-tr/software/studio/tests/fixtures/battery-20261013-1540.csv

# 来源：health-20261013-154006-b5f6ebe.csv + run-20261013-154006-b5f6ebe.jsonl（一号鸭，build_fixture.py 反推）
t | v | cls
0 | 8.074 | rest
1 | 8.068 | rest
2 | 8.142 | rest
3 | 8.144 | rest
4 | 8.086 | rest
5 | 8.102 | rest
6 | 8.130 | rest
7 | 8.151 | rest
8 | 8.144 | rest
9 | 8.146 | rest
10 | 8.128 | rest
11 | 8.138 | rest
12 | 8.139 | rest
13 | 8.140 | rest
14 | 8.141 | rest
15 | 8.142 | rest
16 | 8.133 | rest
17 | 8.123 | rest
18 | 8.092 | rest
19 | 8.128 | rest
20 | 8.118 | rest
21 | 8.097 | rest
22 | 8.134 | rest
23 | 8.115 | rest
24 | 8.104 | rest
25 | 8.112 | rest
26 | 8.111 | rest
27 | 8.110 | rest
28 | 8.079 | rest
29 | 8.075 | rest
30 | 8.031 | rest
31 | 7.973 | light
32 | 8.060 | light
33 | 8.057 | light
34 | 8.054 | light
35 | 7.991 | light
36 | 8.062 | light
37 | 8.051 | light
38 | 7.979 | light
39 | 8.070 | light
40 | 8.061 | light
41 | 8.031 | light
42 | 8.038 | heavy
43 | 7.986 | heavy
44 | 7.999 | heavy
45 | 8.044 | heavy
46 | 8.054 | light
47 | 7.905 | light
48 | 7.951 | heavy
49 | 8.033 | heavy
50 | 8.034 | heavy
51 | 7.905 | light
52 | 7.933 | heavy
53 | 8.035 | heavy
54 | 8.028 | heavy
55 | 7.910 | light
56 | 7.990 | heavy
57 | 8.039 | heavy
58 | 8.053 | light
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
